AyaElbelasi/rc-car/media/breadboard-1.jpg

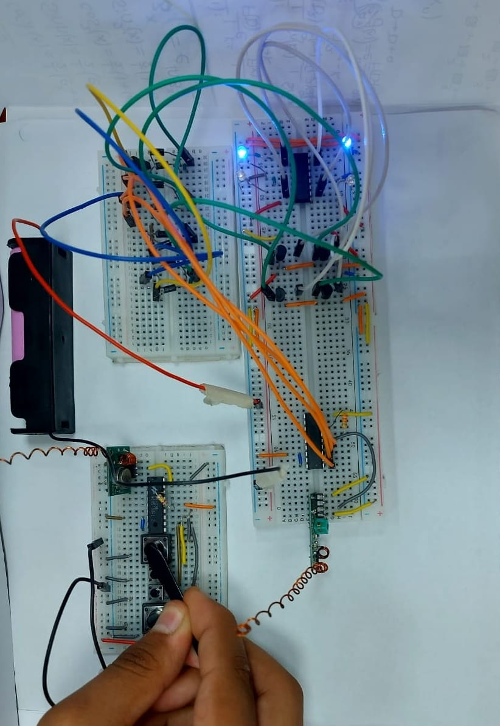
media/breadboard-1.jpg
