AyaElbelasi/rc-car/media/breadboard-2.jpg

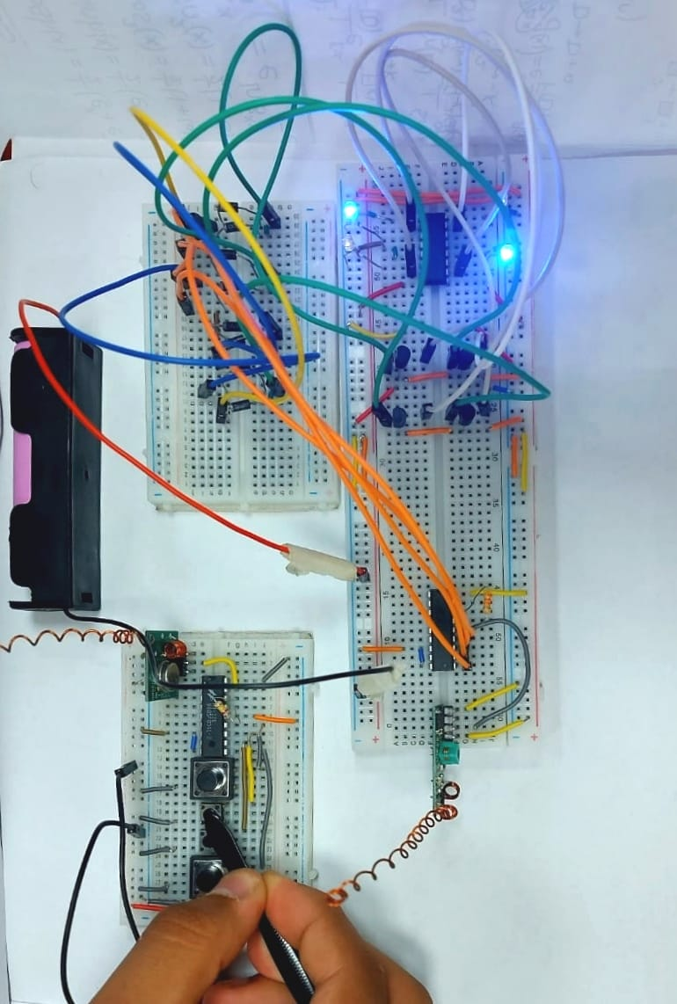
media/breadboard-2.jpg
