AyaElbelasi/rc-car/media/breadboard-4.jpg

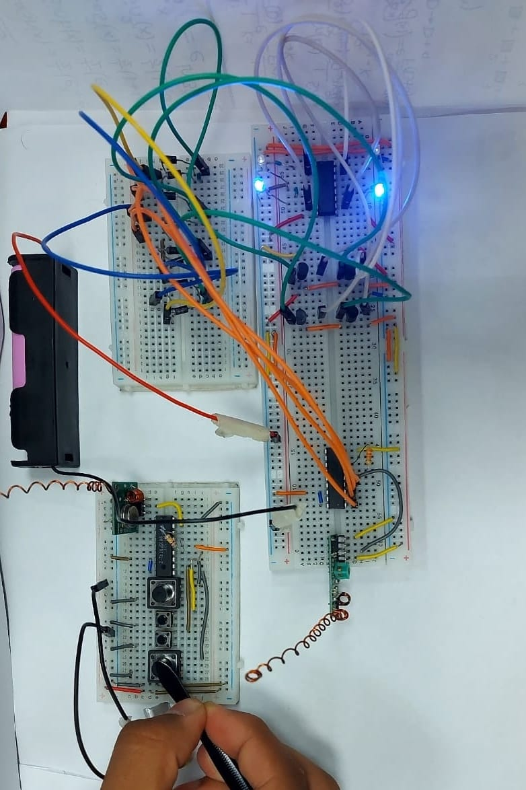
media/breadboard-4.jpg
