AyaElbelasi/rc-car/media/button-back.jpg

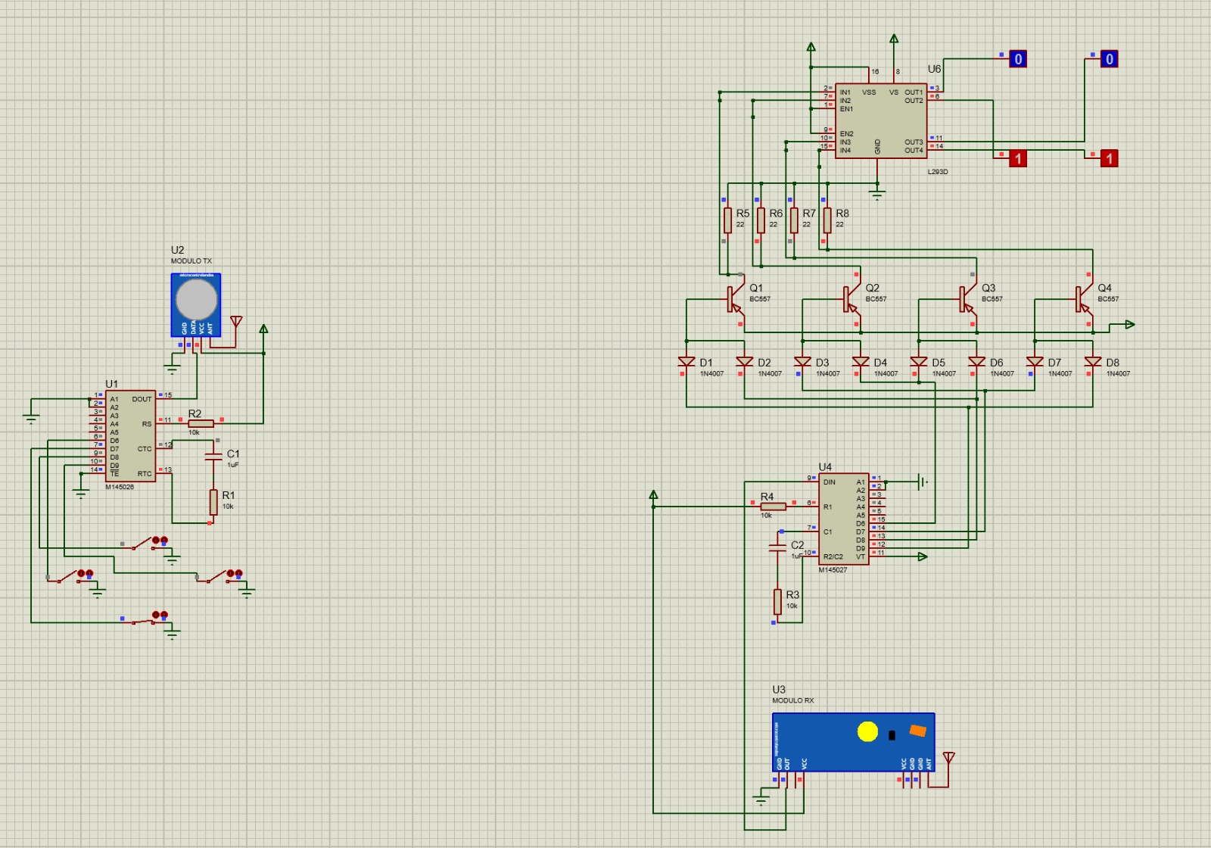
media/button-back.jpg
