AyaElbelasi/rc-car/media/button-forward.jpg

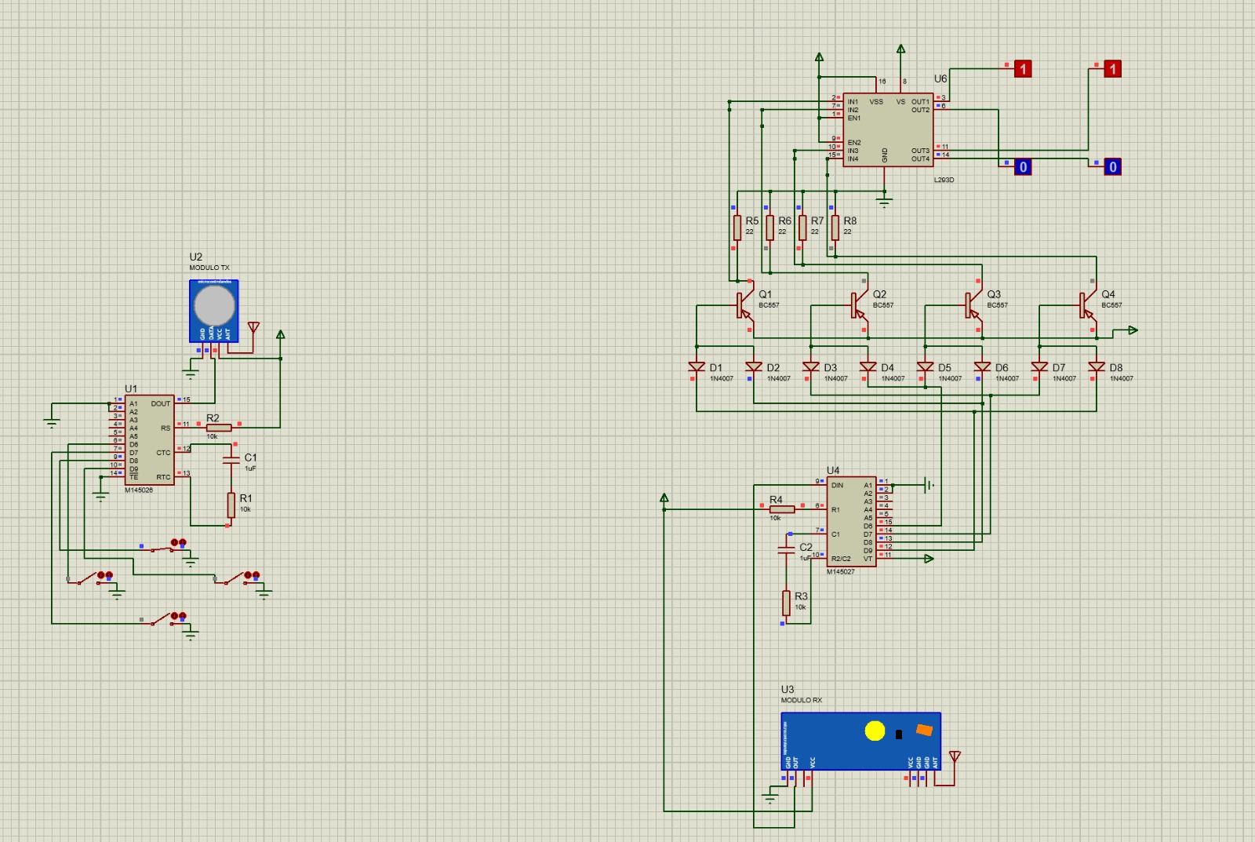
media/button-forward.jpg
