AyaElbelasi/rc-car/media/button-left.jpg

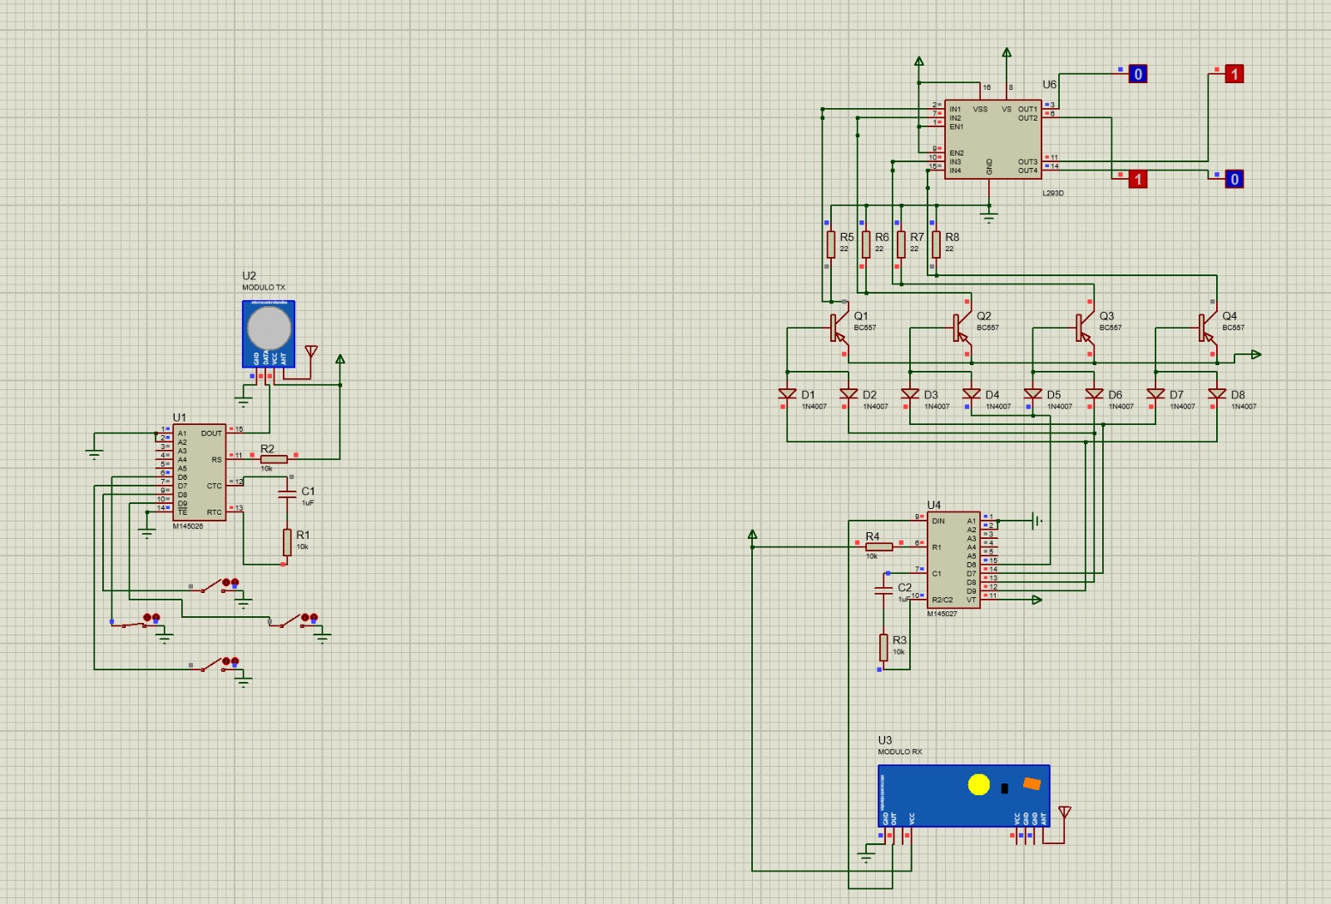
media/button-left.jpg
