AyaElbelasi/rc-car/media/car-1.jpg

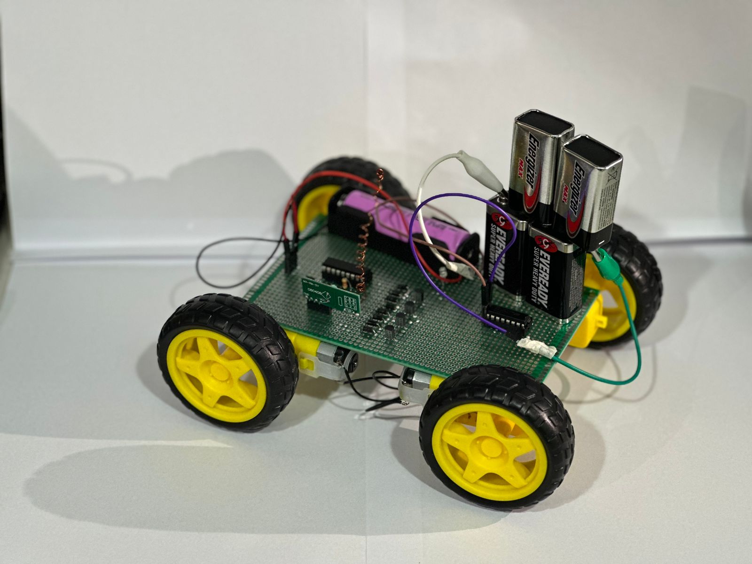
media/car-1.jpg
