AyaElbelasi/rc-car/media/car-pcb-bottom.jpg

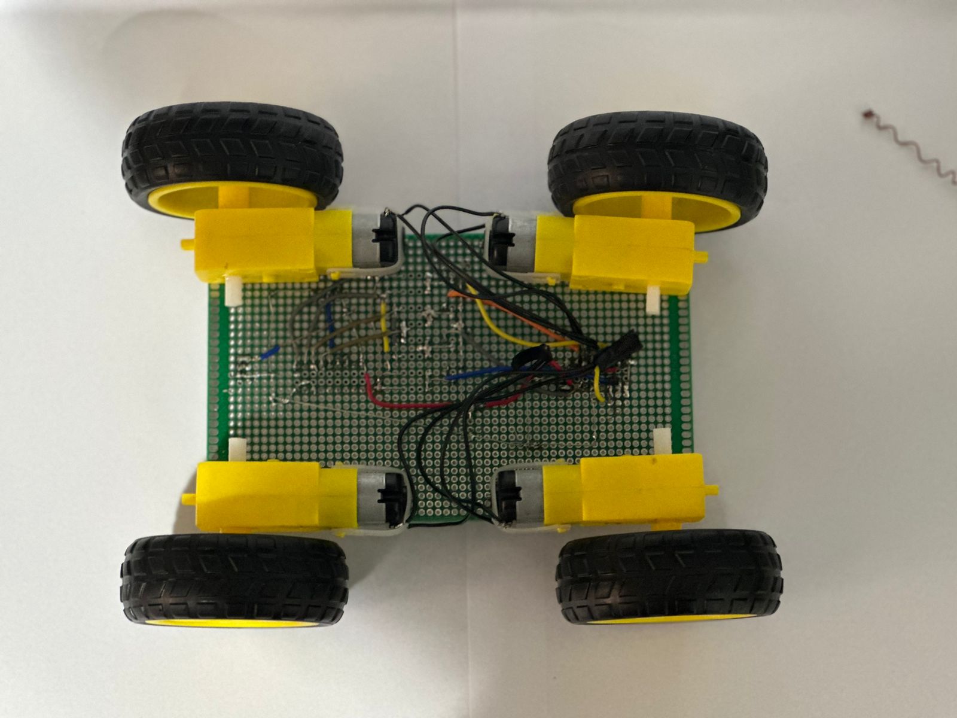
media/car-pcb-bottom.jpg
