AyaElbelasi/rc-car/media/car-pcb-top.jpg

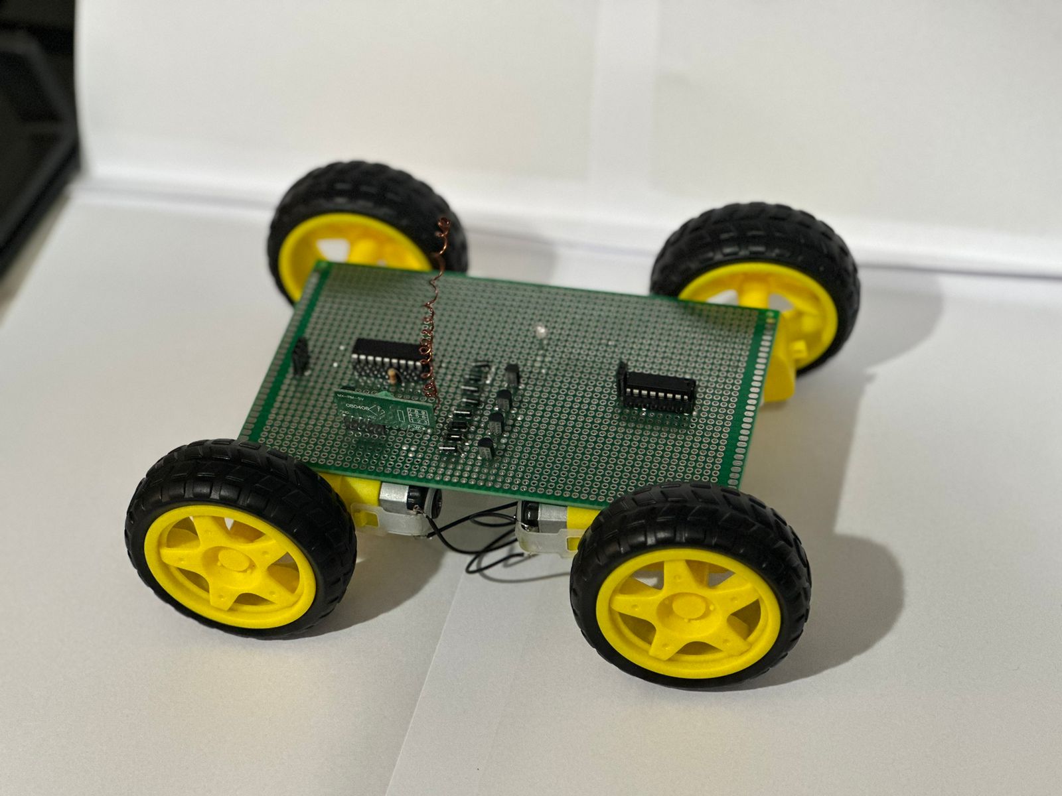
media/car-pcb-top.jpg
