AyaElbelasi/rc-car/media/car.jpg

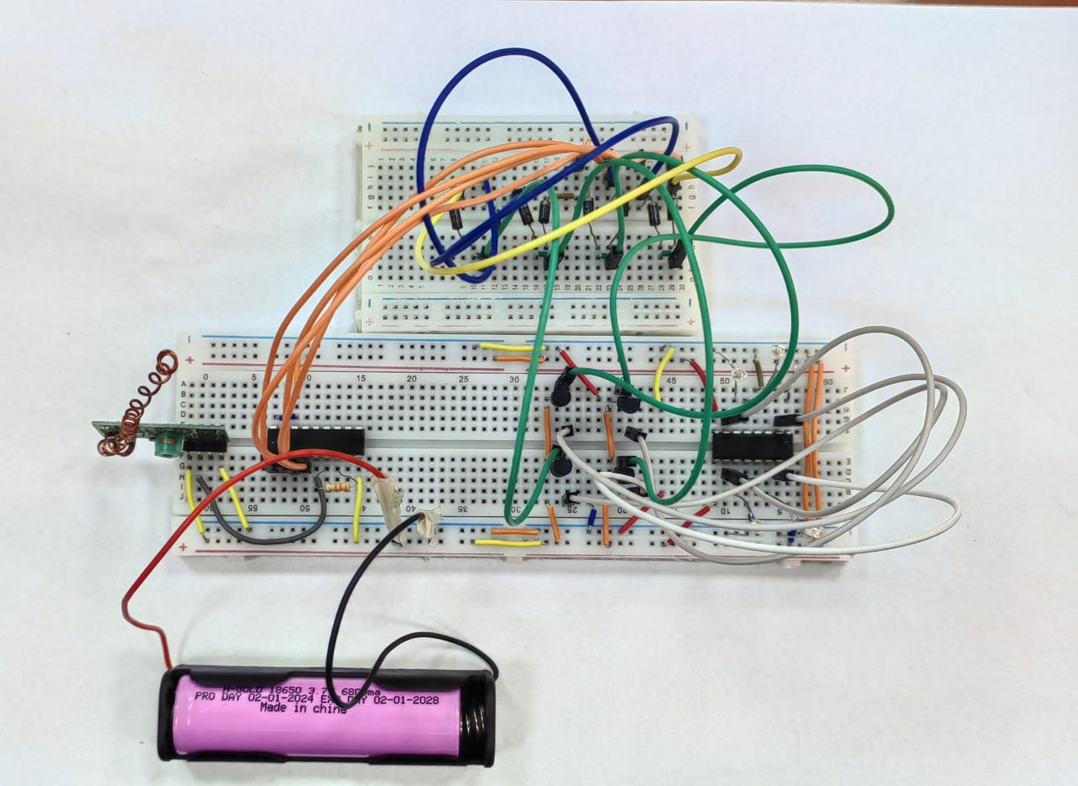
media/car.jpg
