AyaElbelasi/rc-car/media/logic-case-1.jpg

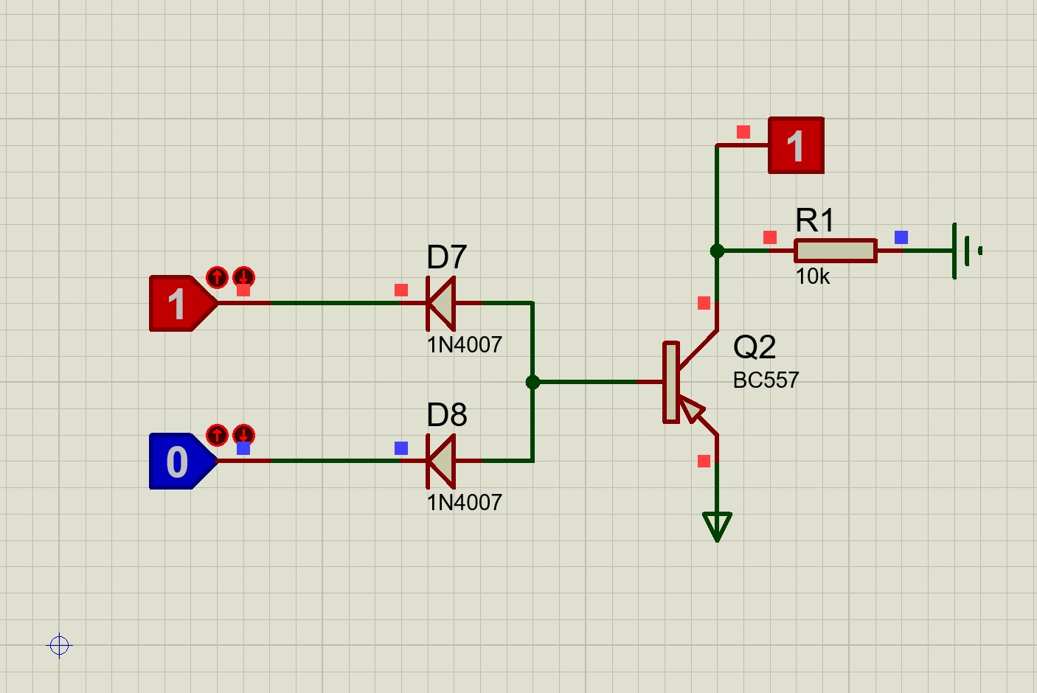
media/logic-case-1.jpg
