AyaElbelasi/rc-car/media/logic-case-2.jpg

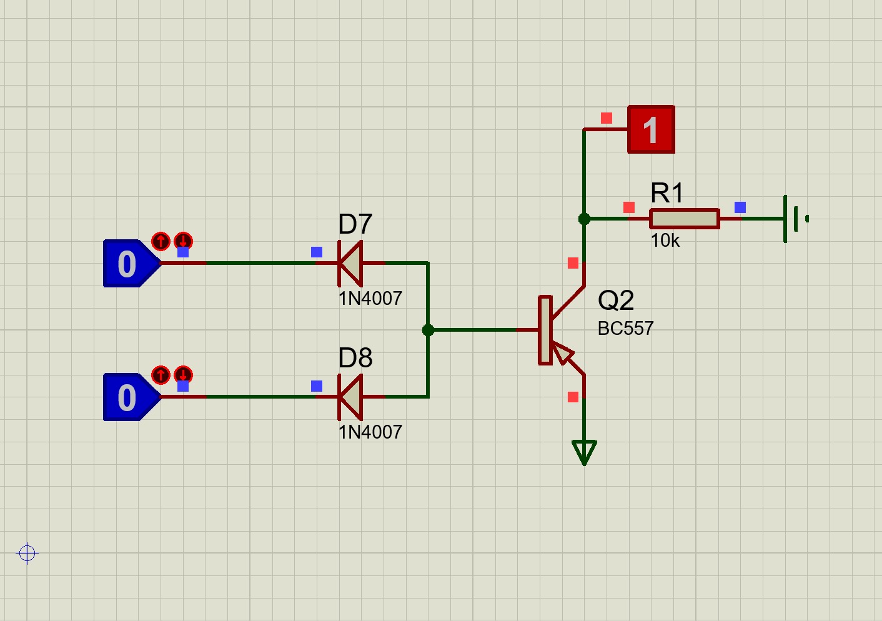
media/logic-case-2.jpg
