AyaElbelasi/rc-car/media/logic-case-3.jpg

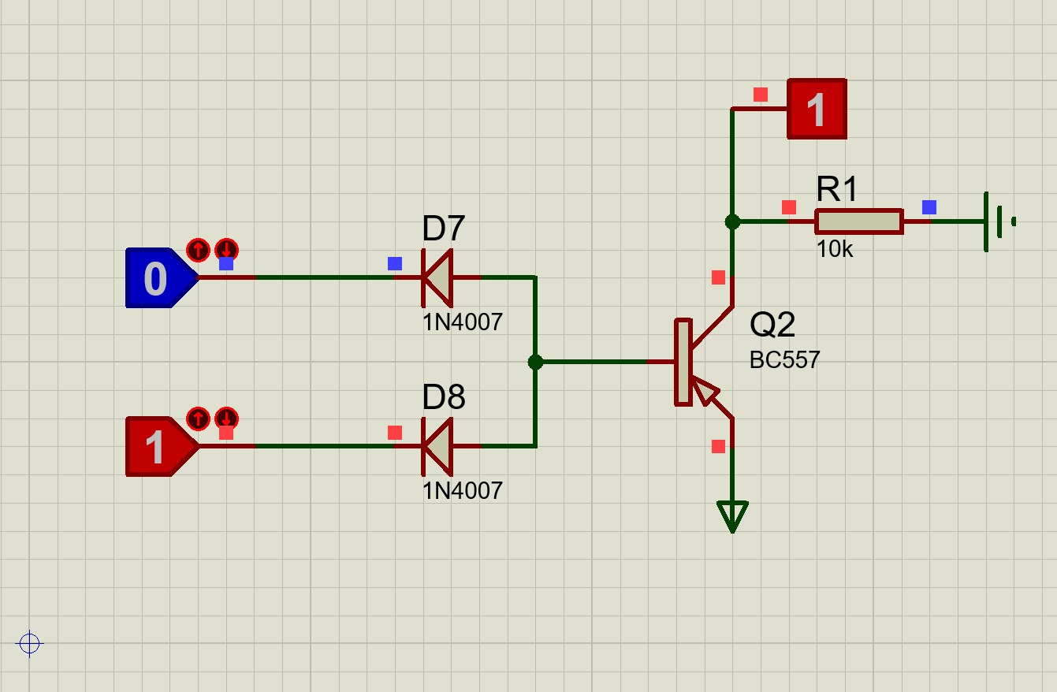
media/logic-case-3.jpg
