AyaElbelasi/rc-car/media/logic-case-4.jpg

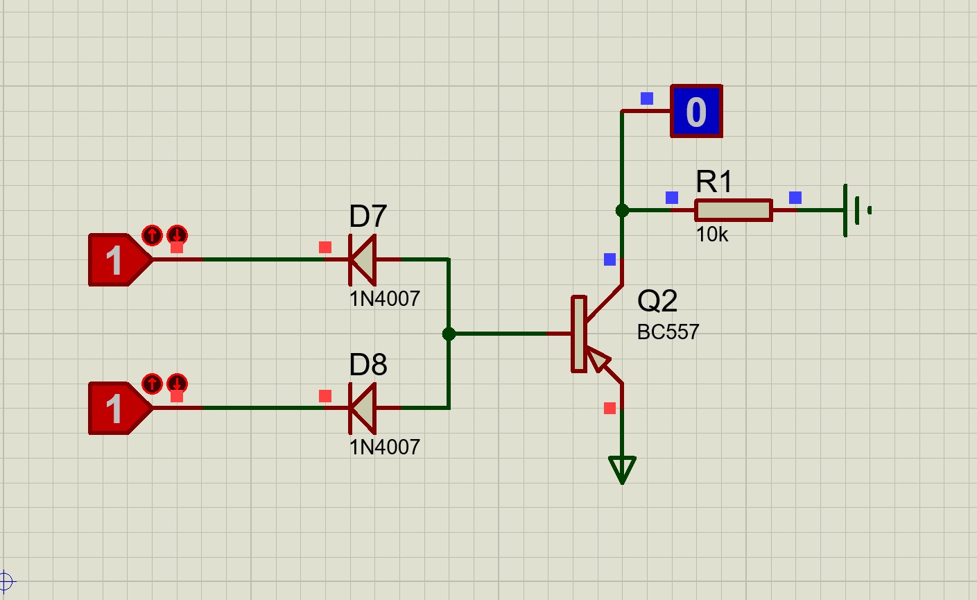
media/logic-case-4.jpg
