AyaElbelasi/rc-car/media/remote-back.jpg

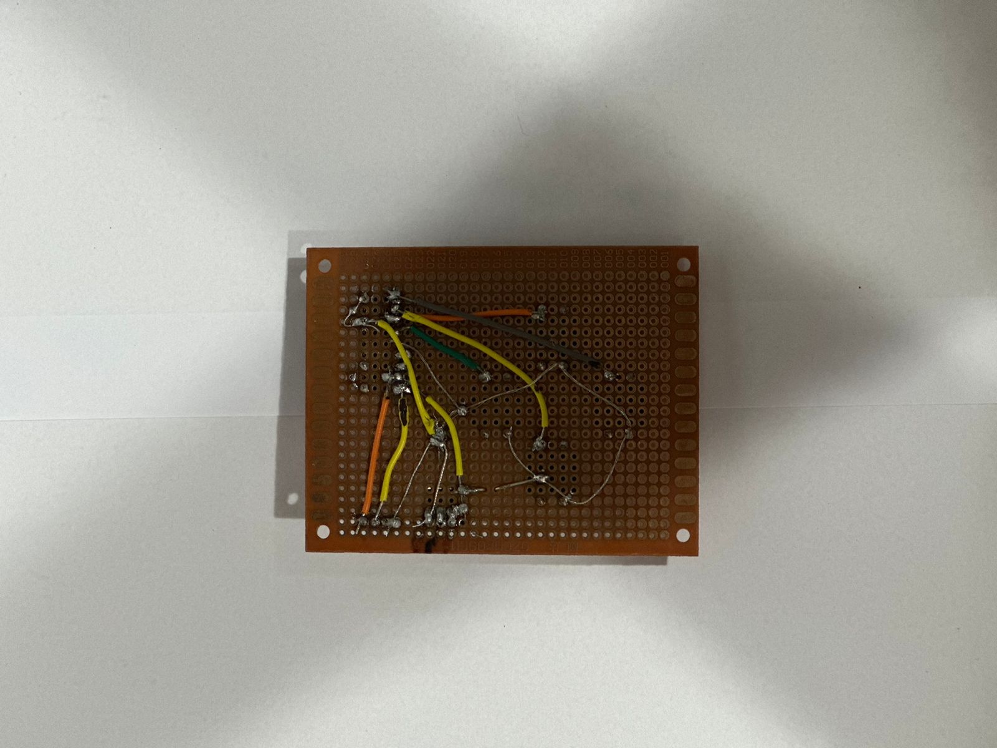
media/remote-back.jpg
