AyaElbelasi/rc-car/media/remote.jpg

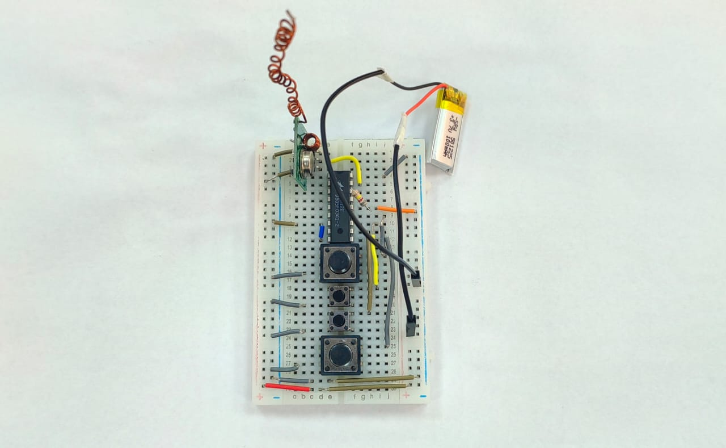
media/remote.jpg
