AyaElbelasi/rc-car/media/schematic.jpg

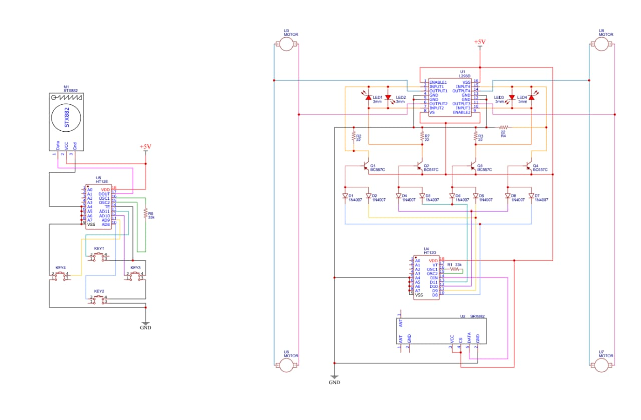
media/schematic.jpg
