AyaElbelasi/rc-car/(list of files, drawings)

Other design files:
rc-car.pdsprj
